nicoleviarengo/Proyecto-Hidroponia/proyecto presentado.jpg

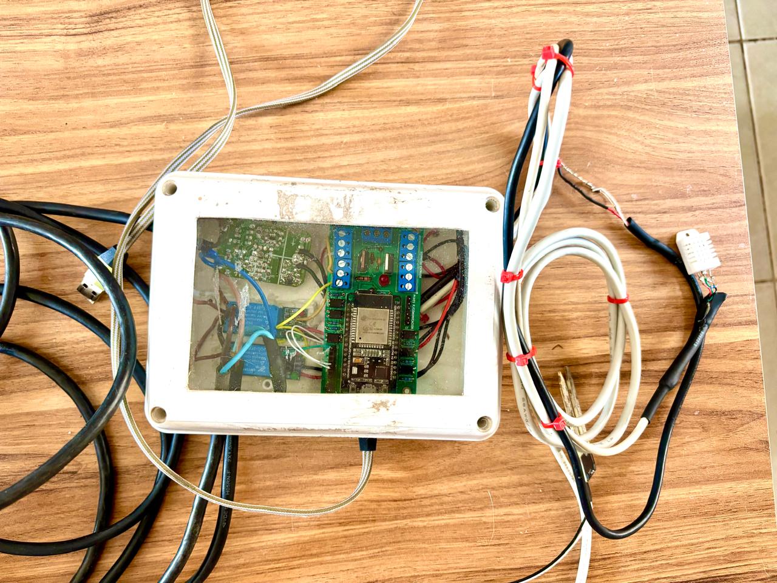
proyecto presentado.jpg
