nicoleviarengo/Proyecto-Hidroponia/maceta hidroponia.stl

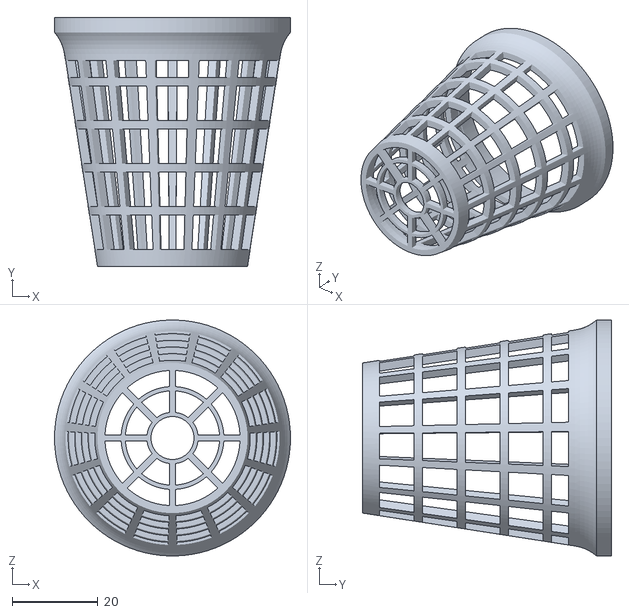
[picture p9: CAD file, 2024-09-09]
maceta hidroponia.stl
55.0 x 58.0 x 55.0
