nicoleviarengo/Proyecto-Hidroponia/Archivos KiCad/Proyecto Nicole.kicad_pcb

## KiCad design Archivos KiCad/Proyecto Nicole.kicad_pcb (2024-12-10)

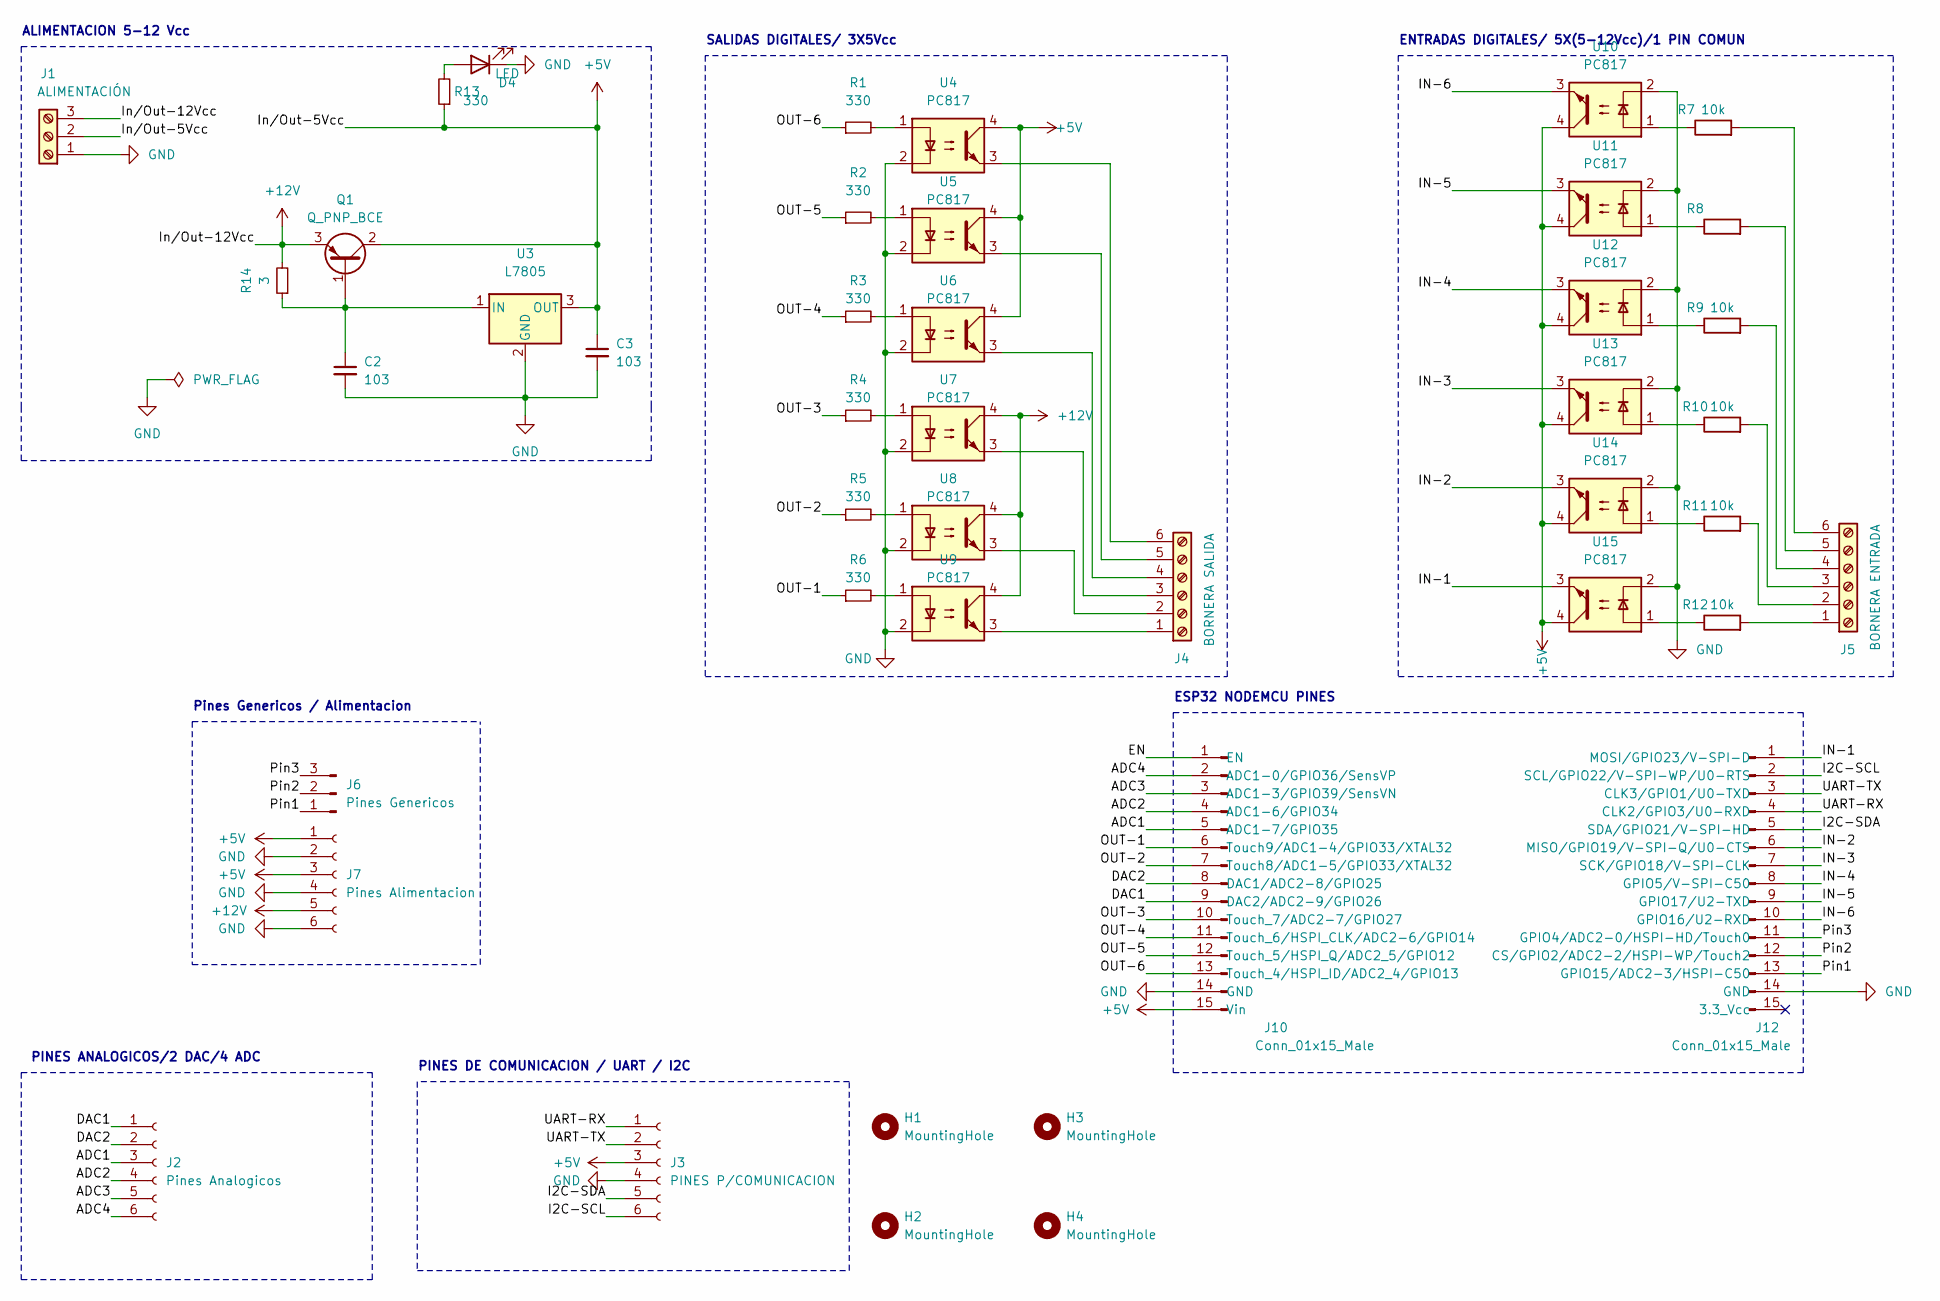
[picture p10: schematic Proyecto Nicole.kicad_sch]

Parts:
C2, C3: 103; C_Disc_D4.3mm_W1.9mm_P5.00mm
D4: LED; LED_D4.0mm
H1, H2, H3, H4: MountingHole; MountingHole_2.5mm_Pad
J1: ALIMENTACIÓN; TerminalBlock_Phoenix_MKDS-3-3-5.08_1x03_P5.08mm_Horizontal
J2: Pines Analogicos; PinSocket_1x06_P2.54mm_Vertical
J3: PINES P/COMUNICACION; PinSocket_1x06_P2.54mm_Vertical
J4: BORNERA SALIDA; TerminalBlock_Phoenix_MKDS-3-6-5.08_1x06_P5.08mm_Horizontal
J5: BORNERA ENTRADA; TerminalBlock_Phoenix_MKDS-3-6-5.08_1x06_P5.08mm_Horizontal
J6: Pines Genericos; PinSocket_1x03_P2.54mm_Vertical
J7: Pines Alimentacion; PinSocket_1x06_P2.54mm_Vertical
J10, J12: Conn_01x15_Male; PinSocket_1x15_P2.54mm_Vertical
Q1: Q_PNP_BCE; TO-220-3_Vertical
R1, R2, R3, R4, R5, R6, R13: 330; R_Axial_DIN0207_L6.3mm_D2.5mm_P7.62mm_Horizontal
R7, R8, R9, R10, R11, R12: 10k; R_Axial_DIN0207_L6.3mm_D2.5mm_P7.62mm_Horizontal
R14: 3; R_Axial_DIN0207_L6.3mm_D2.5mm_P7.62mm_Horizontal
U3: L7805; TO-220-3_Vertical
U4, U5, U6, U7, U8, U9, U10, U11, U12, U13, U14, U15: PC817; DIP-4_W7.62mm

Connections:
+5V: C3.1, J1.2, J3.3, J7.1, J7.3, J10.15 (Vin), Q1.2 (C), R13.1, U3.3 (OUT), U4.4, U5.4, U6.4, U10.4, U11.4, U12.4, U13.4, U14.4, U15.4
+12V: J1.3, J7.5, Q1.3 (E), R14.2, U7.4, U8.4, U9.4
/ADC1: J2.3, J10.5 (ADC1-7/GPIO35)
/ADC2: J2.4, J10.4 (ADC1-6/GPIO34)
/ADC3: J2.5, J10.3 (ADC1-3/GPIO39/SensVN)
/ADC4: J2.6, J10.2 (ADC1-0/GPIO36/SensVP)
/DAC1: J2.1, J10.9 (DAC2/ADC2-9/GPIO26)
/DAC2: J2.2, J10.8 (DAC1/ADC2-8/GPIO25)
/EN: J10.1 (EN)
/I2C-SCL: J3.6, J12.2 (SCL/GPIO22/V-SPI-WP/U0-RTS)
/I2C-SDA: J3.5, J12.5 (SDA/GPIO21/V-SPI-HD)
/IN-1: J12.1 (MOSI/GPIO23/V-SPI-D), U15.3
/IN-2: J12.6 (MISO/GPIO19/V-SPI-Q/U0-CTS), U14.3
/IN-3: J12.7 (SCK/GPIO18/V-SPI-CLK), U13.3
/IN-4: J12.8 (GPIO5/V-SPI-C50), U12.3
/IN-5: J12.9 (GPIO17/U2-TXD), U11.3
/IN-6: J12.10 (GPIO16/U2-RXD), U10.3
/OUT-1: J10.6 (Touch9/ADC1-4/GPIO33/XTAL32), R6.1
/OUT-2: J10.7 (Touch8/ADC1-5/GPIO33/XTAL32), R5.1
/OUT-3: J10.10 (Touch_7/ADC2-7/GPIO27), R4.1
/OUT-4: J10.11 (Touch_6/HSPI_CLK/ADC2-6/GPIO14), R3.1
/OUT-5: J10.12 (Touch_5/HSPI_Q/ADC2_5/GPIO12), R2.1
/OUT-6: J10.13 (Touch_4/HSPI_ID/ADC2_4/GPIO13), R1.1
/Pin1: J6.1, J12.13 (GPIO15/ADC2-3/HSPI-C50)
/Pin2: J6.2, J12.12 (CS/GPIO2/ADC2-2/HSPI-WP/Touch2)
/Pin3: J6.3, J12.11 (GPIO4/ADC2-0/HSPI-HD/Touch0)
/UART-RX: J3.1, J12.4 (CLK2/GPIO3/U0-RXD)
/UART-TX: J3.2, J12.3 (CLK3/GPIO1/U0-TXD)
GND: C2.2, C3.2, D4.1 (K), J1.1, J3.4, J7.2, J7.4, J7.6, J10.14 (GND), J12.14 (GND), U3.2 (GND), U4.2, U5.2, U6.2, U7.2, U8.2, U9.2, U10.2, U11.2, U12.2, U13.2, U14.2, U15.2
unnamed: D4.2 (A), R13.2
unnamed: J4.1, U9.3
unnamed: J4.2, U8.3
unnamed: J4.3, U7.3
unnamed: J4.4, U6.3
unnamed: J4.5, U5.3
unnamed: J4.6, U4.3
unnamed: J5.1, R12.2
unnamed: J5.2, R11.2
unnamed: J5.3, R10.2
unnamed: J5.4, R9.2
unnamed: J5.5, R8.2
unnamed: J5.6, R7.2
unnamed: C2.1, Q1.1 (B), R14.1, U3.1 (IN)
unnamed: R1.2, U4.1
unnamed: R2.2, U5.1
unnamed: R3.2, U6.1
unnamed: R4.2, U7.1
unnamed: R5.2, U8.1
unnamed: R6.2, U9.1
unnamed: R7.1, U10.1
unnamed: R8.1, U11.1
unnamed: R9.1, U12.1
unnamed: R10.1, U13.1
unnamed: R11.1, U14.1
unnamed: R12.1, U15.1

Notes on the sheet:
PINES DE COMUNICACION / UART / I2C
SALIDAS DIGITALES/ 3X5Vcc
ALIMENTACION 5-12 Vcc
ENTRADAS DIGITALES/ 5X(5-12Vcc)/1 PIN COMUN
PINES ANALOGICOS/2 DAC/4 ADC
ESP32 NODEMCU PINES
Pines Genericos / Alimentacion

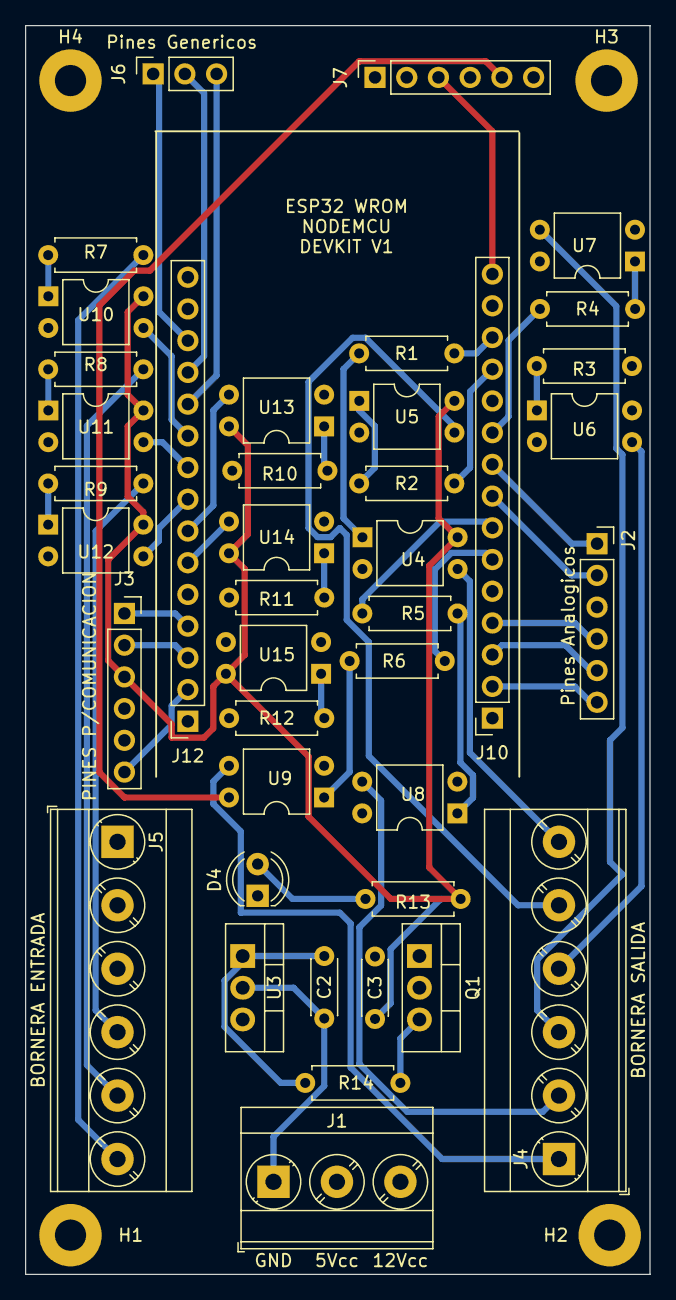
[picture p11: board Proyecto Nicole.kicad_pcb from above]

Board: 2 copper layers, 50.0 x 100.0 mm, 44 parts (0 on the bottom side), 54 nets.
