nicoleviarengo/Proyecto-Hidroponia/(commit log)

2024-09-09 maceta en 3d
    [maceta hidroponia.stl]
2024-12-10 Diseño de la placa
    [Proyecto Nicole.kicad_pcb, Proyecto Nicole.kicad_sch]
2024-12-10 Programa en Arduino
